ag4015/EEBug/README.md

# EEBug
First year project as a student at Imperial College London. This device uses infrared sensors to follow a line.
