ag4015/EEBug/circuit_diagram.png

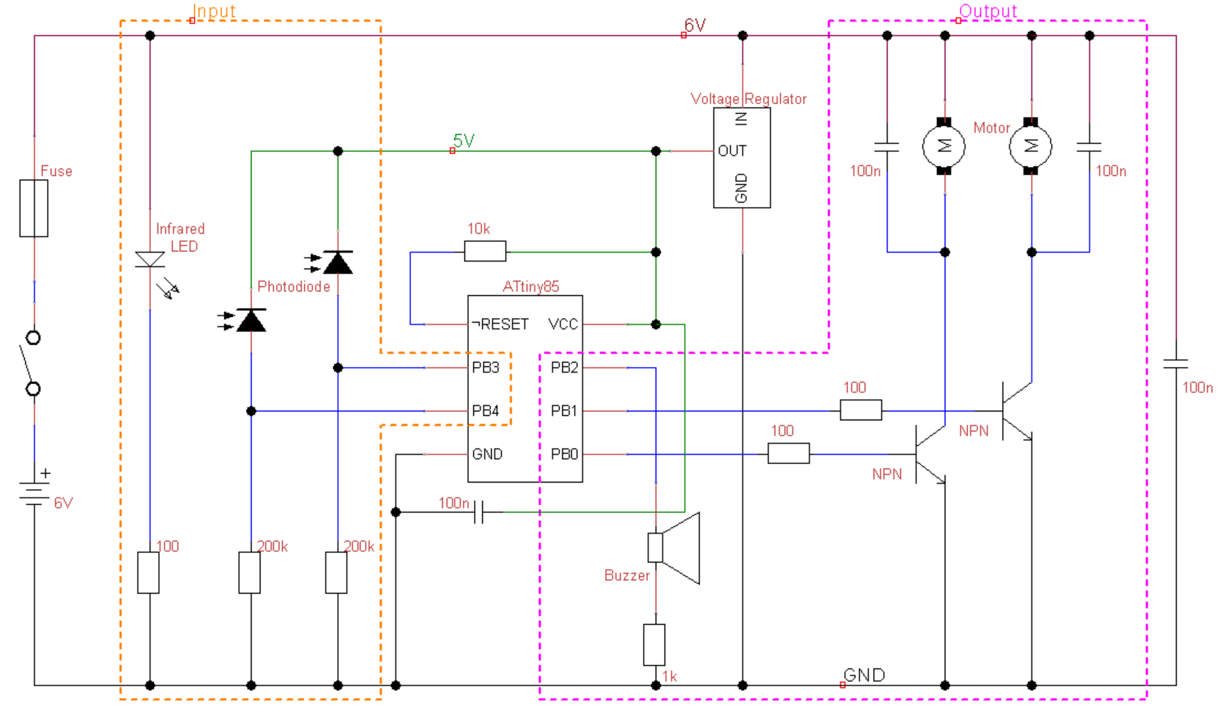
circuit_diagram.png
